HarryBateman/Siren_Electrical/Capture.PNG

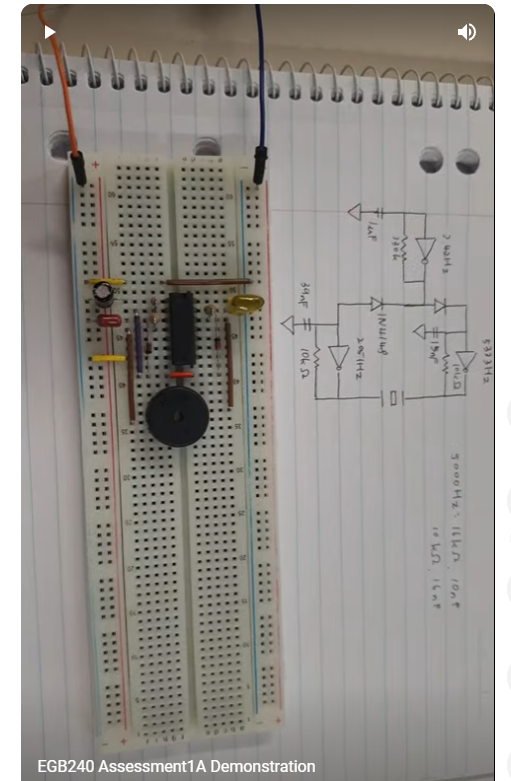
Capture.PNG
