HarryBateman/Siren_Electrical/EGB240_Assessment1_Portfolio_n11291419.pdf

Mark Broadmeadow (n5470897)

# EGB240 Electronic Design

## Assessment 1: PCB Alarm Circuit Design Portfolio

### Submitted 24/03/2023

### Harrison Flatman-Bateman (n11291419)

### Executive Summary

This portfolio documents the design for a Two Tone Siren, which will be fabricated on a printed circuit board (PCB). The design will be constructed with the following specifications:

- Supplied with two AA batteries (3v supply)
- IC socket
- Activated from a slide switch (on-off)
- 2.67Khz and 3.28Khz tones switching at 2Khz (56.46, 41.67 duty cycle respectively)
- supply current 5mA, peak current 19mA.
- Physical size is 55.7 x 27.90 mm (excluding battery holder)

The two-tone siren will be constructed on the top side of the PCB, While the copper wires will be placed on the bottom, to minimise the layers reducing the cost.

### Contents

### 1. Circuit schematic

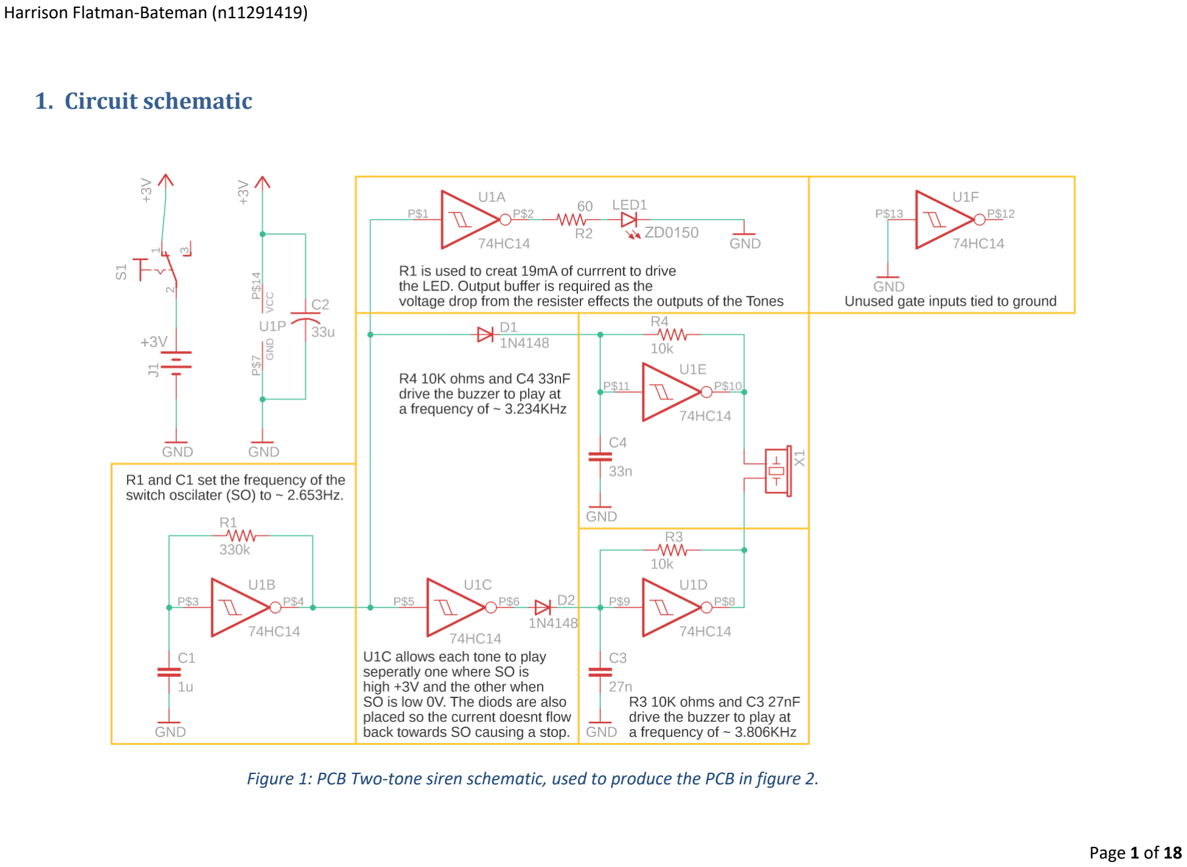
[picture p2: page 2]

Harrison Flatman-Bateman (n11291419)

Page 1 of 18

Figure 1: PCB Two-tone siren schematic, used to produce the PCB in figure 2.

ZD0150

+3V

### 2. Summary of design and operation

Items used in this project was the piezoelectric buzzer (PS1720P02) and The Hex Inverting Schmitt trigger IC (74HC14). The Schmitt trigger is operated by supplying 3V to the supply pin and 0V to the ground trigger which enables the ability to add Schmitt triggers to the circuit, enabling the ability to add oscillators within the circuit to create a two-tone siren circuit.

The piezoelectric buzzer can be used to create a tone supplying a 3V voltage at a specific frequency allowing the ability to create an audible frequency or even a low frequency to drive the switching between the two tones to create a two-tone siren.

The circuit I have created is a two-tone siren circuit with an added LED to emphasize the alarm behaviour. These behaviours were created using the piezoelectric buzzer and The Hex Inverting Schmitt trigger IC. In designing this circuit there is a Switching Oscillator circuit (SO) a low frequency at ~2Hz, to drive the transition between the frequencies (Tone 1, Tone 2). For these Tones to not be played at the same time another Schmitt trigger is placed in between one of the Tones and the Oscillating switch, which causes the two Tones to be out of phase of each other.

A bypass capacitor was added after noticing a distortion when turning on the Two-tone siren, caused by long lengths of wire creating parasitic inductance. this was fixed by implementing a bypass capacitor from the positive and negative pins of the Schmitt trigger IC. However, now when turning off the capacitor a discharge like sound was created by the large capacitance of the 33uF capacitor therefore It has since been changed to 10uF to minimise these effects.

For visual feedback I added a red LED I first added this without another Schmitt trigger however it was causing a voltage drop on the tone generators due to the resistance I needed to power the LED. To fix this issue I put a Schmitt trigger before the resister and the LED to avoid a voltage drop across the tone generators, I used a 60ohm resister at 3 volts to create 19-amp current which was more than enough to power the bulb.

When designing the two-tone siren, the frequencies used to create a tone is important. From diagram 1 I chose to use a frequency that had a high decibel range, considering the fact that the frequencies can be close enough in values to still be distinguished by the user. Tone 1 was chosen to be 3.28KHz and tone 2 2.67KHz. As indicated by the black dots.

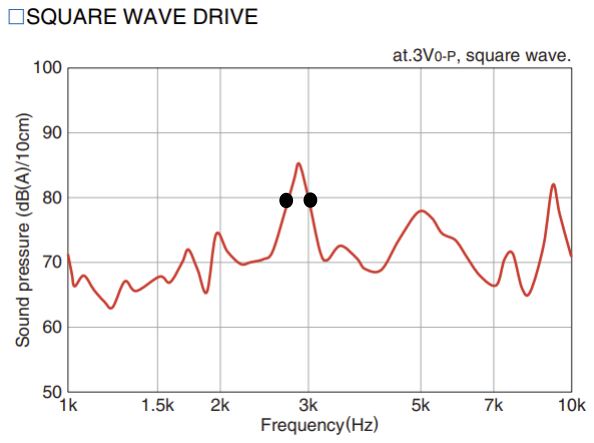
[picture p3: figure]

Diagram 1: decibels produced from different frequency from the buzzer.

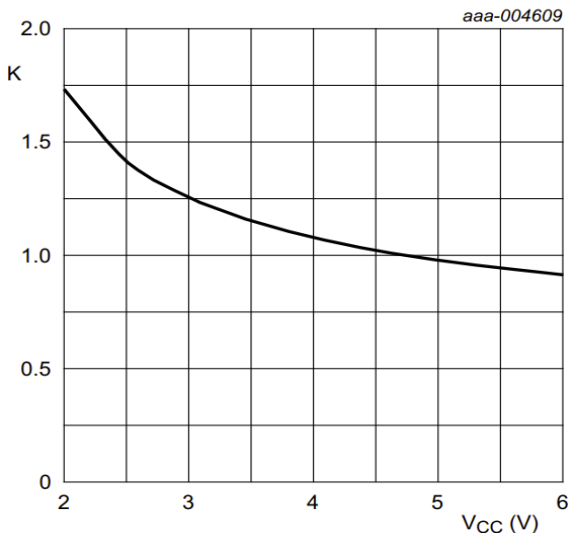
[picture p4: figure]

To calculate the frequencies a K value must be determined from a diagram from the Schmitt trigger diagram. In diagram 2 it shows a value of K respect to the supplied voltage. In this case the system is powered by 2 AA batteries creating 3V therefore the diagram shows the K value being
1.25. To then calculate the frequency the following formular can be used to select an appropriate resister then working backwards to find the desired frequencies.

Using the following formular I can determine a value closes to 3.28KHz and 2.67KHz provided the components within QUT S9 resources:

2.05Hz =

1
1.25 × (390 × 10³) × (1 × 10⁻⁶)

2.424KHz =

1
1.25 × (10 × 10³) × (33 × 10⁻⁹)

2.962KHz =

1
1.25 × (10 × 10³) × (27 × 10⁻⁹)

Using the resister and capacitor values to plug into the schematic will create an output frequency that will be used to create a two-tone siren. For any modifications for the two-tone siren the following diagrams and calculation can be used to create a desired frequency.

Diagram 2: constant value K dictated by the amount of voltage supply used to produce frequency calculations.

Equation 1: used to calculate frequencies from a specific supply voltage, resister, and capacitor.

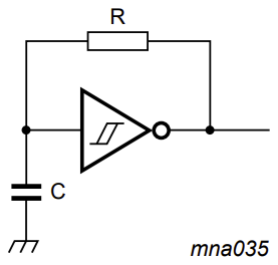
[picture p5: figure]

Diagram 3: Layout used to produce an output frequency.

Page 4 of 18

### 3. PCB layout

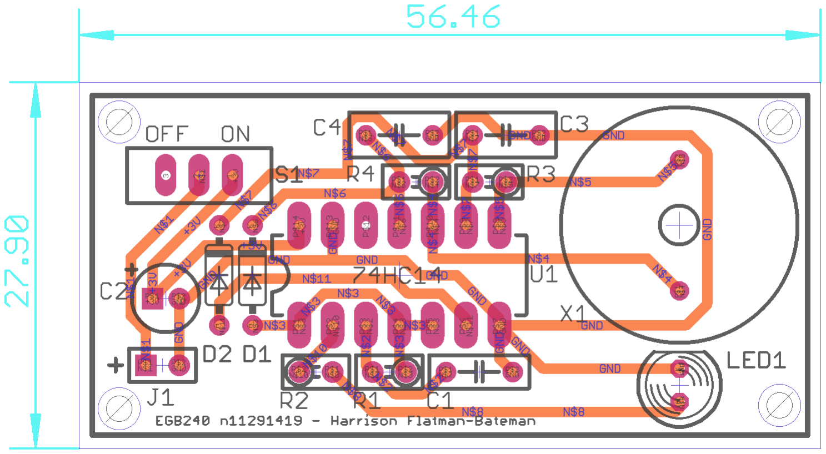
[picture p6: figure]

Figure 2: PCB circuit of the two-tone siren showing the size of the board in mm.

Page 5 of 18

### 4. Bill of materials

Designator Value | Description | Qty | Footprint
C1 | 1u | Capacitor, Radial, Non-polarised, 1uF 35V 12%, 5mm pitch | 1 | CAP-DISC-P5.08
C2 | 33u | Capacitor, Radial, Polarised, 33u 50V, 3.5mm pitch | 1 | CAP-RB-P2.0-D5.0
C3 | 27n | Capacitor, Radial, Non-polarised, MKT, 27nF 100V 10%, 5mm pitch | 1 | CAP-DISC-P5.08
C4 | 33n | Capacitor, Radial, Non-polarised, MKT, 33nF 100V 10%, 5mm pitch | 1 | CAP-DISC-P5.08
D1 | 1N4148 | Diode, 100V 150mA, DO-35 | 1 | DO35-P7.62
D2 | 1N4148 | Diode, 100V 150mA, DO-35 | 1 | DO35-P7.62
LED1 | LED | LED, RED 8mcd Round diffused, 20mA fc, 1.8v fv, 5mm diameter | 1 | ZD0150
J1 | 3V | Battery holder, 3V, 2xAA, flying leads | 1 | BATT-3V
R1 | 330k | Resistor, Axial, Carbon Film, 330K 5% 0.25W | 1 | AXIAL-P2.54
R2 | 60 | Resistor, Axial, Metal Film, 62 1% 0.25W | 1 | AXIAL-P2.54
R3 | 10K | Resistor, Axial, Carbon Film, 10K 1% 0.25W | 1 | AXIAL-P2.54
R4 | 10K | Resistor, Axial, Carbon Film, 10K 1% 0.25W | 1 | AXIAL-P2.54
S1 | | Switch, SPDT, Slide, On-On, 0.1" pitch | 1 | SS-12
U1 | 74HC14 | Hex Schmitt trigger INVERTER, DIP-14 | 1 | DIP-14
U1 | IC socket | IC socket, DIP-14 | 1 | DIP-14
X1 | PS1720P02 | Piezoelectonic buzzer | 1 | PS1720P02

Page 6 of 18

Designator | Manufacturer | MPN | Supplier | SKU | MOQ Price
C1 | Generic | Capacitor, Radial, Non-polarised, 1uF 35V 12%, 5mm pitch | Jaycar | RZ6628 | 1 | 0.75
C2 | Generic | Capacitor, Radial, Polarised, 33u 50V, 3.5mm pitch | Jaycar | RY6818 | 1 | 1.15
C3 | Generic | Capacitor, Radial, Non-polarised, MKT, 27nF 100V 10%, 5mm pitch | Jaycar | RG5090 | 1 | 0.3
C4 | Generic | Capacitor, Radial, Non-polarised, MKT, 33nF 100V 10%, 5mm pitch | Jaycar | RM7095 | 1 | 0.35
D1 | NXP | 1N4148 | Jaycar | ZR-1100 | 1 | 0.95
D2 | NXP | 1N4148 | Jaycar | ZR-1100 | 1 | 0.95
LED1 | Generic | LED, RED 8mcd Round diffused, 20mA fc, 1.8v fv, 5mm diameter | Jaycar | ZD0150 | 1 | 0.4
J1 | Generic | Battery holder, 3V, 2xAA, flying leads | Jaycar | PH-9202 | 1 | 1.6
R1 | Generic | Resistor, Axial, Carbon Film, 330K 5% 0.25W | Jaycar | RR2834 | 1 | 0.68
R2 | Generic | Resistor, Axial, Metal Film, 62 1% 0.25W | Jaycar | RR0543 | 1 | 0.85
R3 | Generic | Resistor, Axial, Carbon Film, 10K 1% 0.25W | Jaycar | RR2798 | 1 | 0.68
R4 | Generic | Resistor, Axial, Carbon Film, 10K 1% 0.25W | Jaycar | RR2798 | 1 | 0.68
S1 | NKK Switches | SS12SDP4 | Digi Key | 360-2922-ND | 1 | 4.94
U1 | Texas Instruments | SN74HC14N | Jaycar | ZC-4821 | 1 | 2.75
U1 | Texas Instruments | IC socket, DIP-14 | Jaycar | PI-6501 | 1 | 0.5
X1 | TDK | PS1720P02 | Element14 | 1669968 | 1 | 1.35

Page 7 of 18

### 5. Assembly overlay

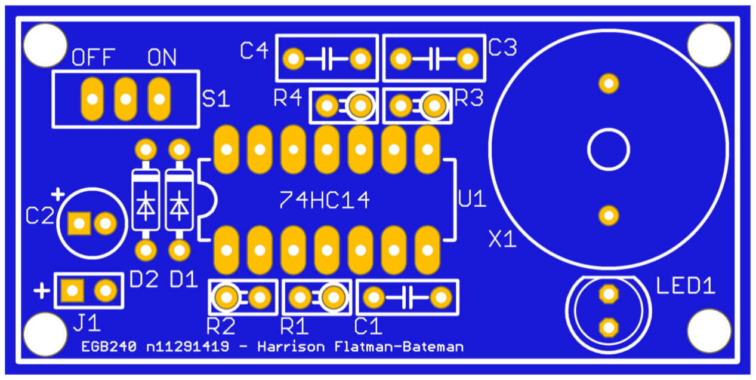
[picture p7: figure]

Figure 3: Assembly overlay and instructions for two-tone siren.

When constructing the board, it is important that the respected diode and other polarised components face their respected positions. This can be dictated by the thick line for a diode and a positive icon for a polarised capacitor. It is also important to Solder in the IC socket before implementing the Schmitt trigger IC, this allows the IC to be easily replaced or removed when required.

M3 bolt size holes have been produced for an industry standard mounting option. with a 3.2mm diameter hole to account for any clearance issues.

### 6. Photos of assembled prototype

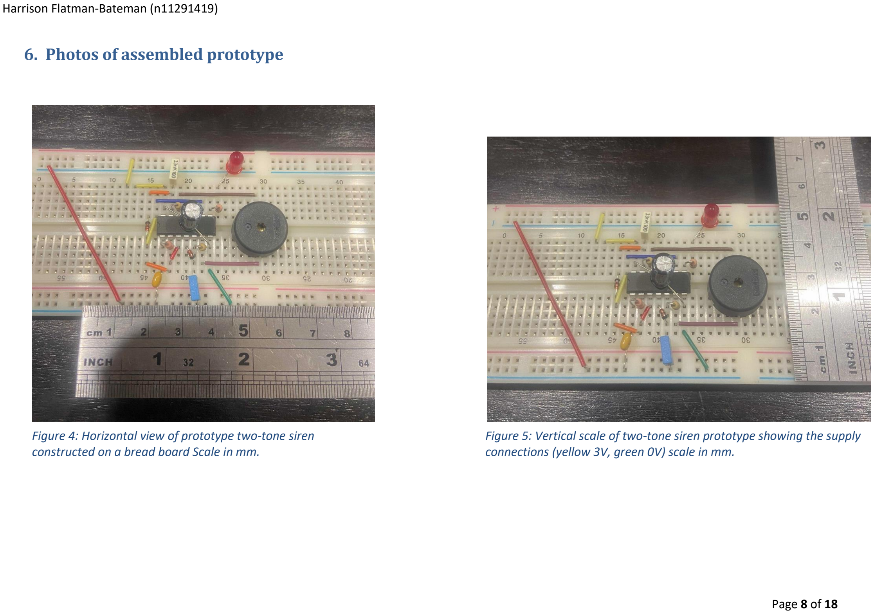
[picture p8: page 9]

Page 8 of 18

Figure 4: Horizontal view of prototype two-tone siren constructed on a bread board Scale in mm.

Figure 5: Vertical scale of two-tone siren prototype showing the supply connections (yellow 3V, green 0V) scale in mm.

### 7. Simulation circuit and results

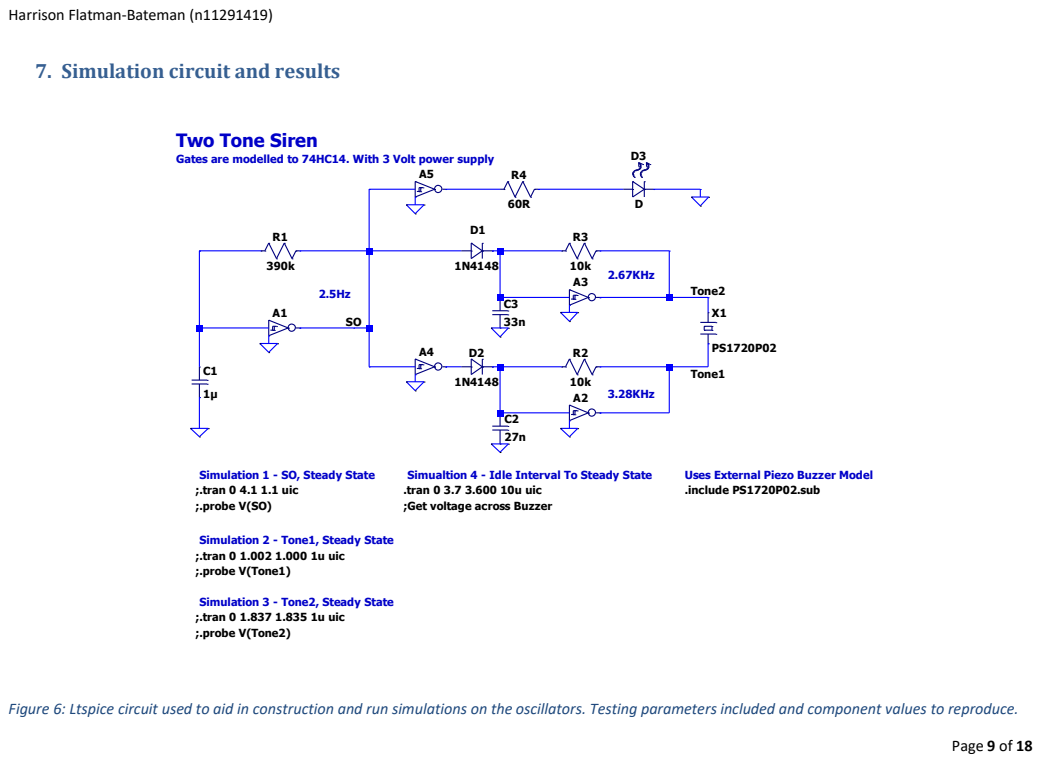
[picture p9: page 10]

Gates are modelled to 74HC14. With 3 Volt power supply

Simulation 1 - SO, Steady State
;.tran 0 4.1 1.1 uic
;.probe V(SO)

Simualtion 4 - Idle Interval To Steady State
.tran 0 3.7 3.600 10u uic
;Get voltage across Buzzer

Uses External Piezo Buzzer Model
.include PS1720P02.sub

Figure 6: Ltspice circuit used to aid in construction and run simulations on the oscillators. Testing parameters included and component values to reproduce.

Page 10 of 18

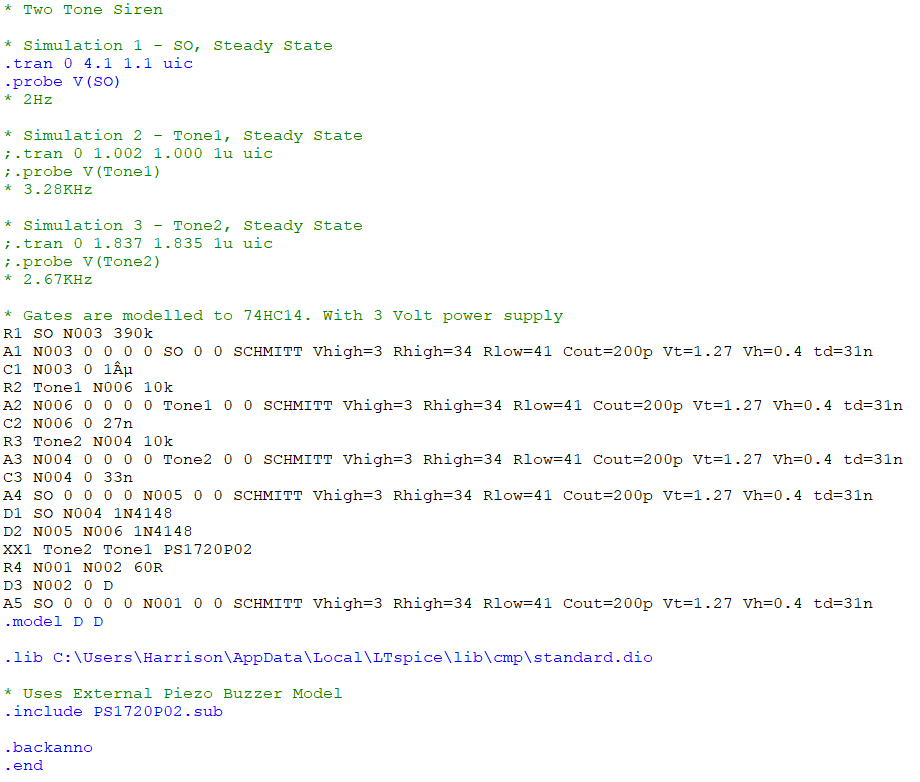
[picture p10: figure]

Figure 7: Ltspice netlist for circuit in figure 6.

Page 11 of 18

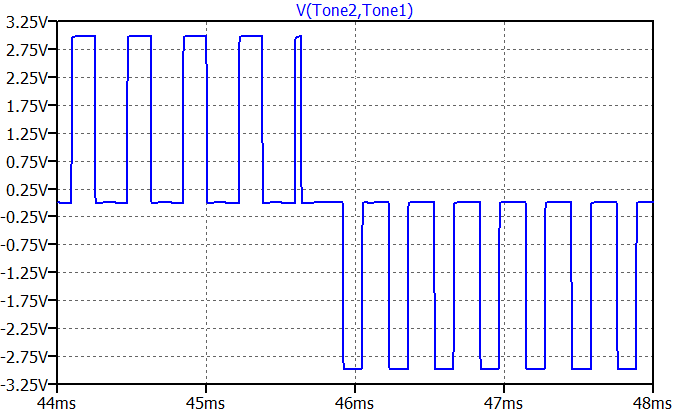
[picture p11: figure]

Figure 8: Plot of the voltage across the buzzer showing the correlation between the oscillating switch and the two tones.

Figure 8 shows the switch changing, causing the tone from the buzzer changing from 2.67KHz to 3.28KHz causing Tone 1 from figure 6 to flow in the opposite direction showing the buzzers peak at -3V after 46ms.

Page 12 of 18

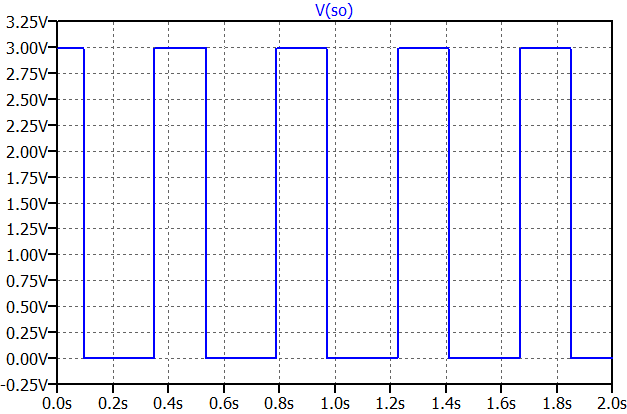
[picture p12: figure]

Figure 9: Plot of the oscillating switch that controls when the tones switch driving the two tones to play separately.

Page 13 of 18

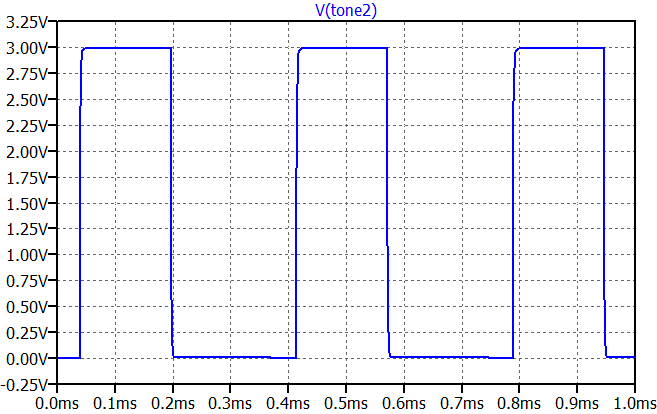
[picture p13: figure]

Figure 20: Shows tone 2 with a frequency of 2.67KHz and a duty cycle of 46.67%

Page 14 of 18

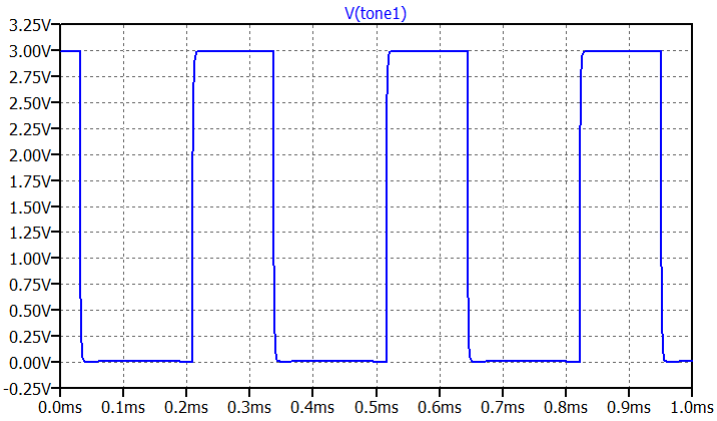
[picture p14: figure]

Figure 11: Shows tone 1 with a frequency of 3.28KHz and a duty cycle of 41.67%

Page 15 of 18

### 8. Experimental results

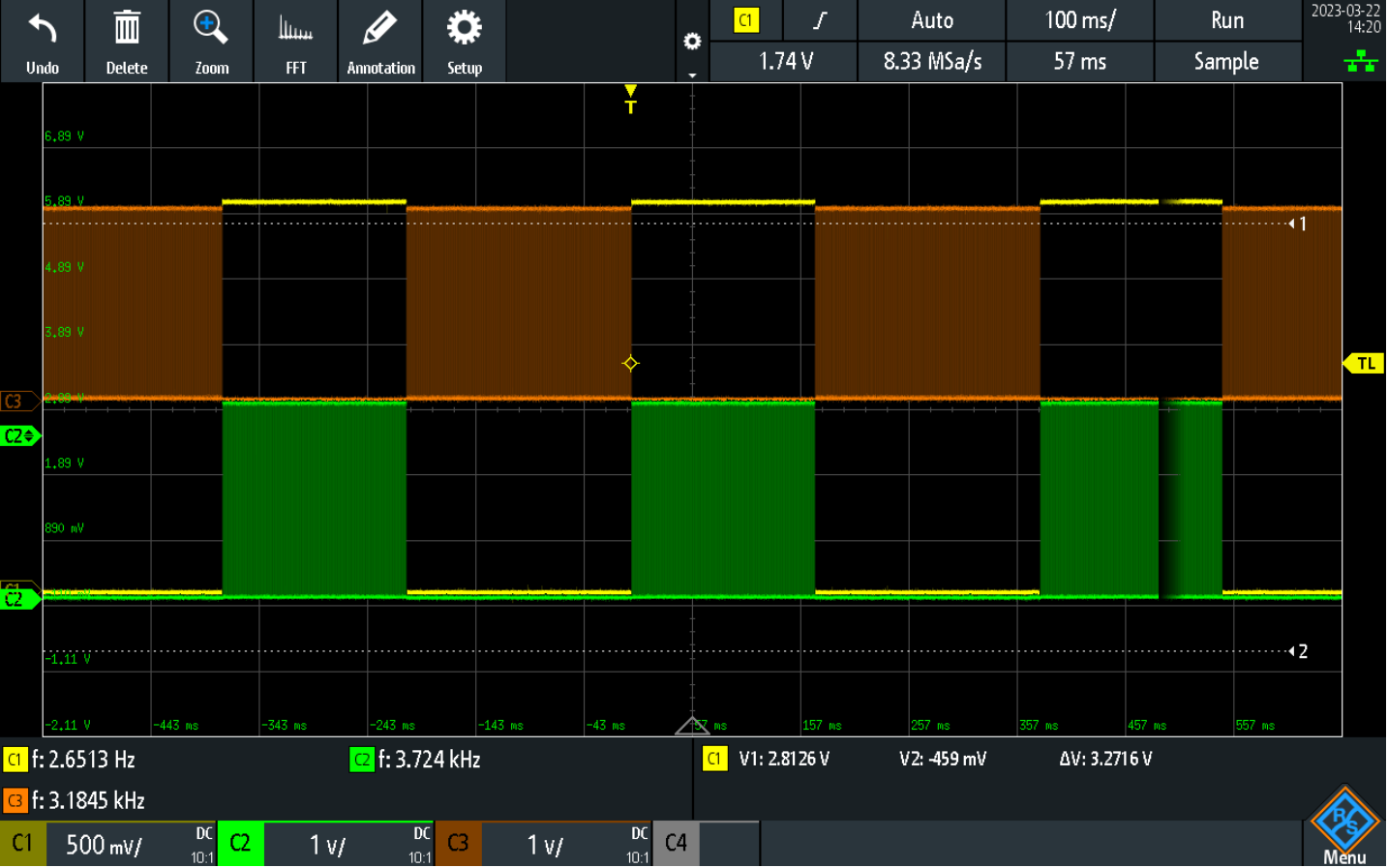
[picture p15: figure]

Figure 13:The oscilloscope captures the relations between the switching oscillator and two tones generated by the IC.

As the switching oscillator is driven low (0V) Tone 2 from figure 6 is switched on and generates a frequency of 3.184Khz for the buzzer. When the switch is driven high to 3V, Tone 2 is then turned off and Tone 1 starts playing with a frequency of 3.724KHz.

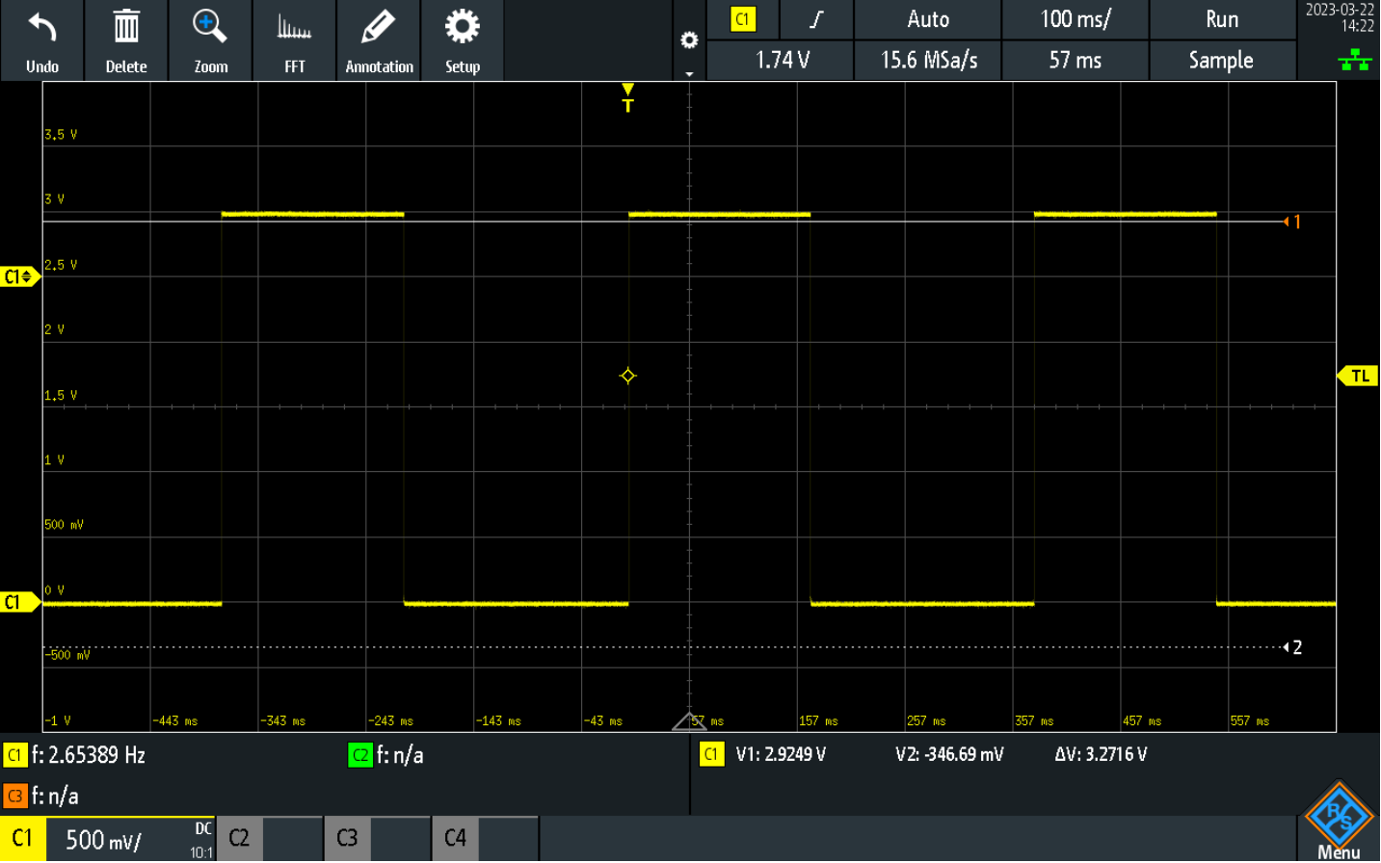
[picture p16: figure]

Page 16 of 18

Figure 14: Captured on the oscilloscope shows the oscillating switch, at a frequency of 2.653Hz and a duty cycle of 44.82%

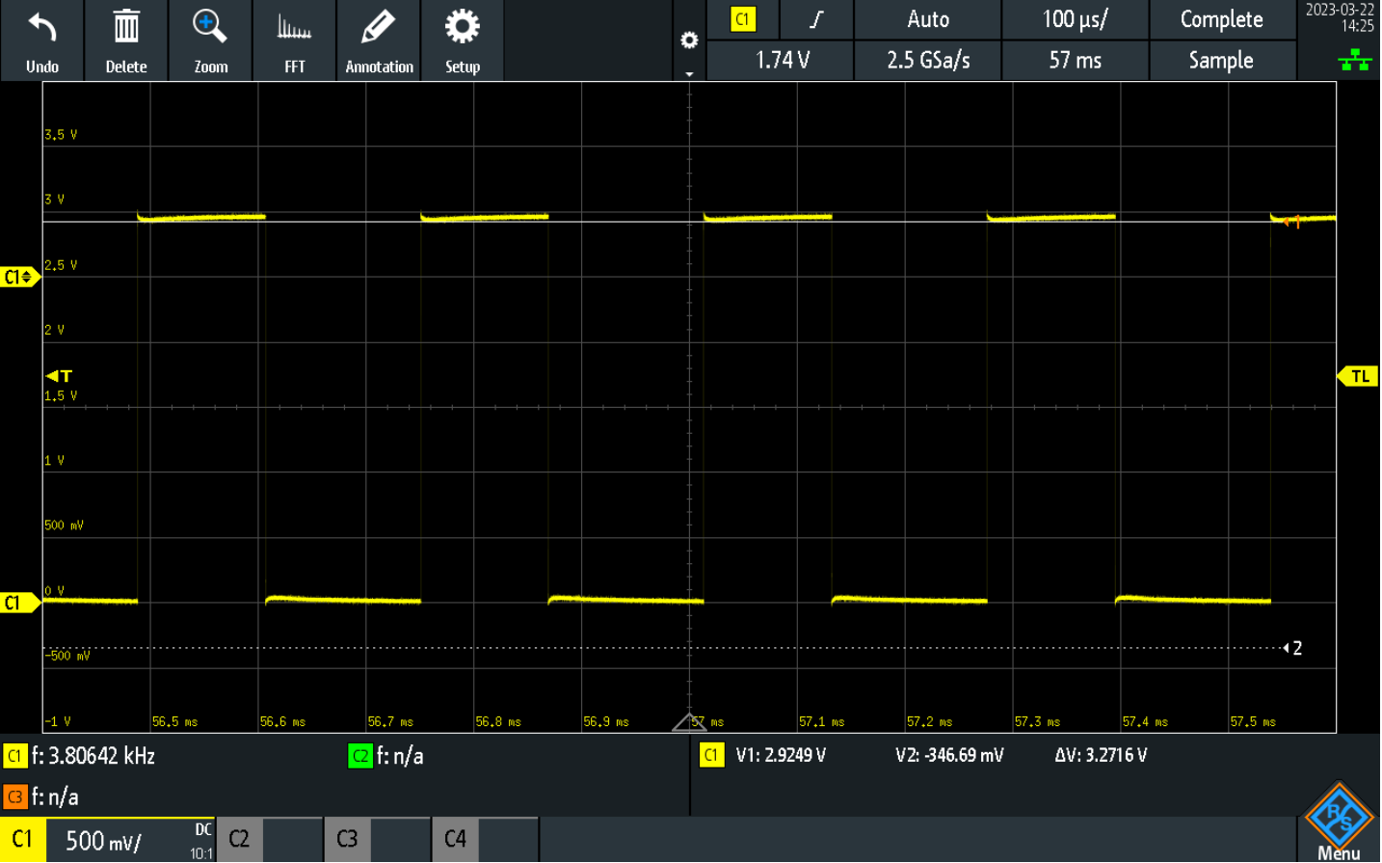
[picture p17: figure]

Page 17 of 18

Figure 15: captures tone 1 from figure 6 with a frequency of 3.806KHz and a duty cycle of 41.67%

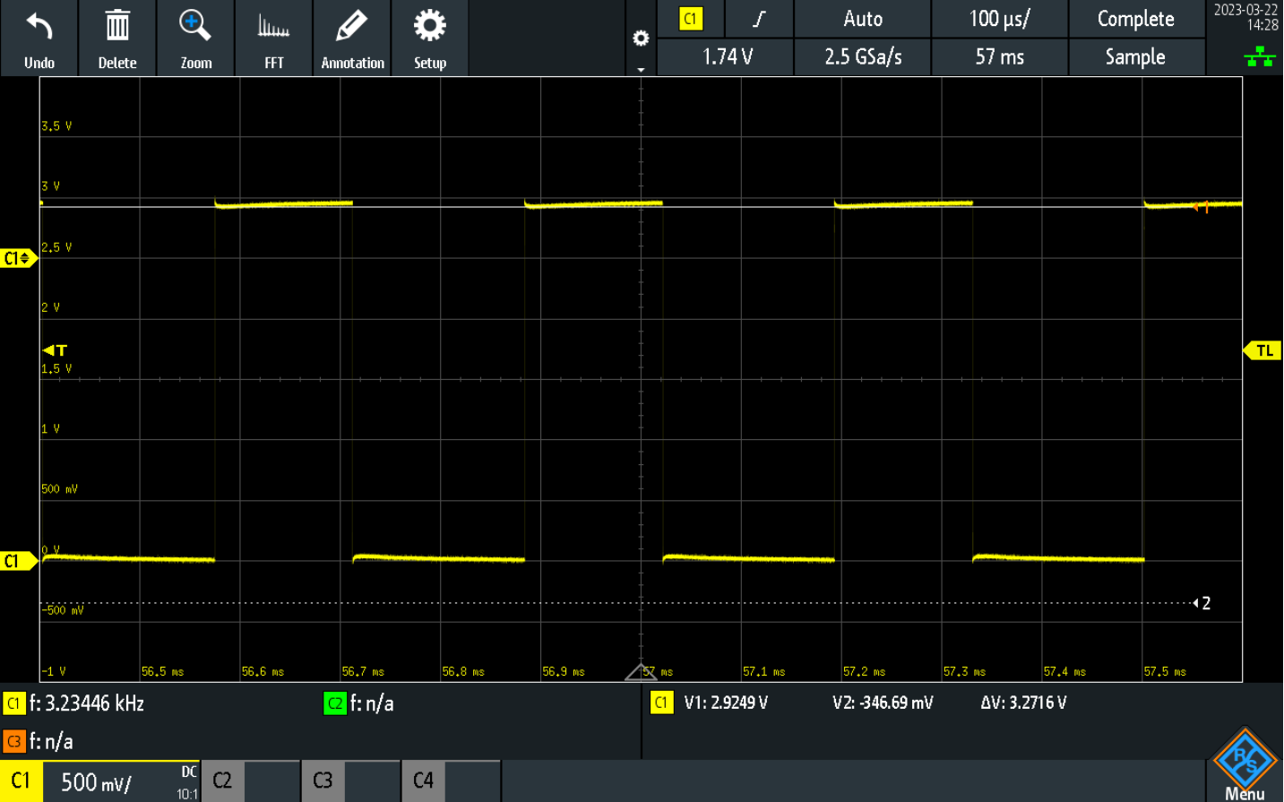
[picture p18: figure]

Page 18 of 18

Figure 16:Ccaptures tone 2 from figure 6 with a frequency of 3.234KHz and a duty cycle of 46.67%
