HarryBateman/Siren_Electrical/Data/soin.PNG

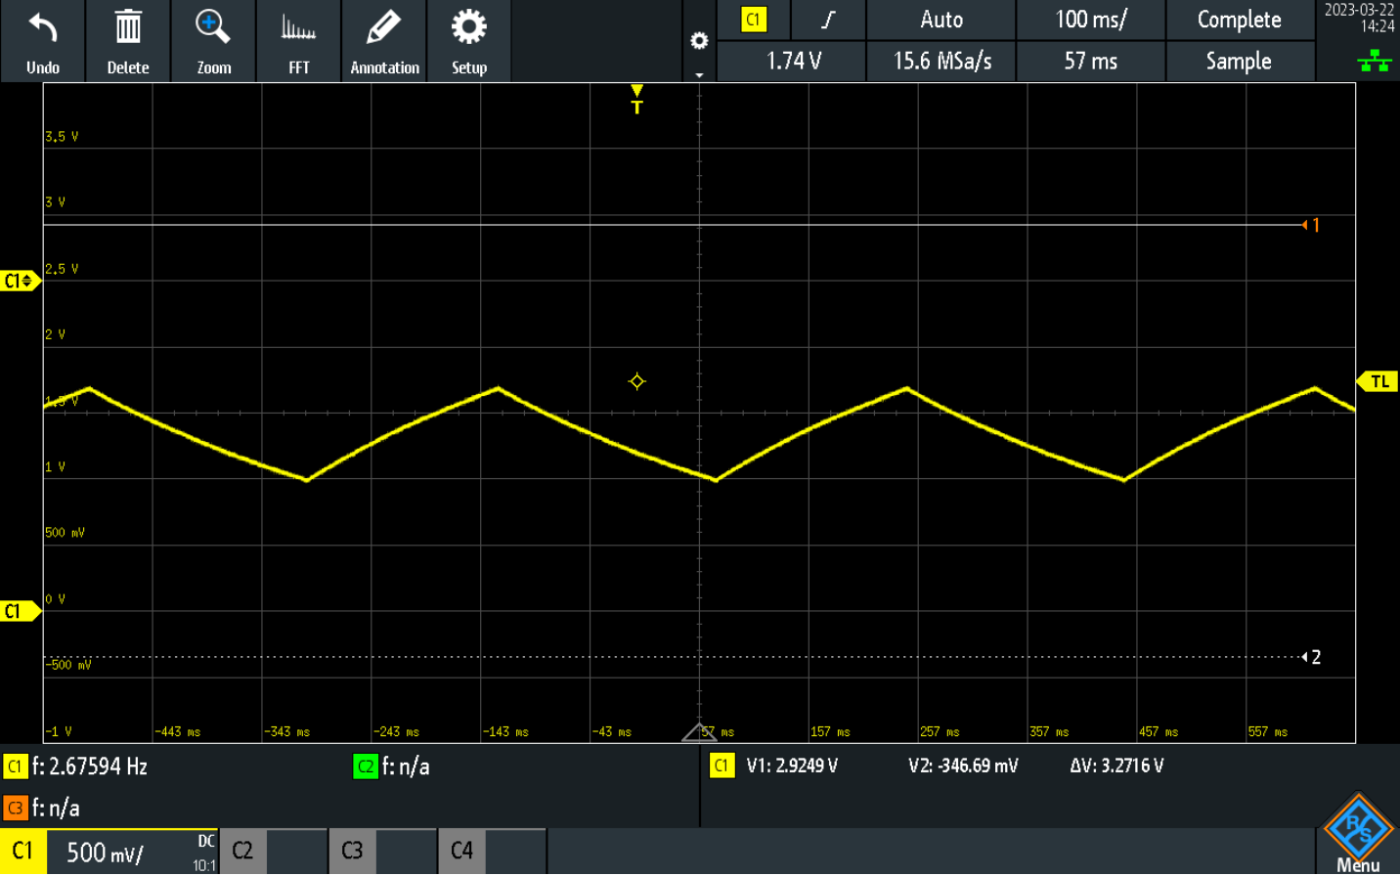
Data/soin.PNG
