HarryBateman/Siren_Electrical/Data/tin.PNG

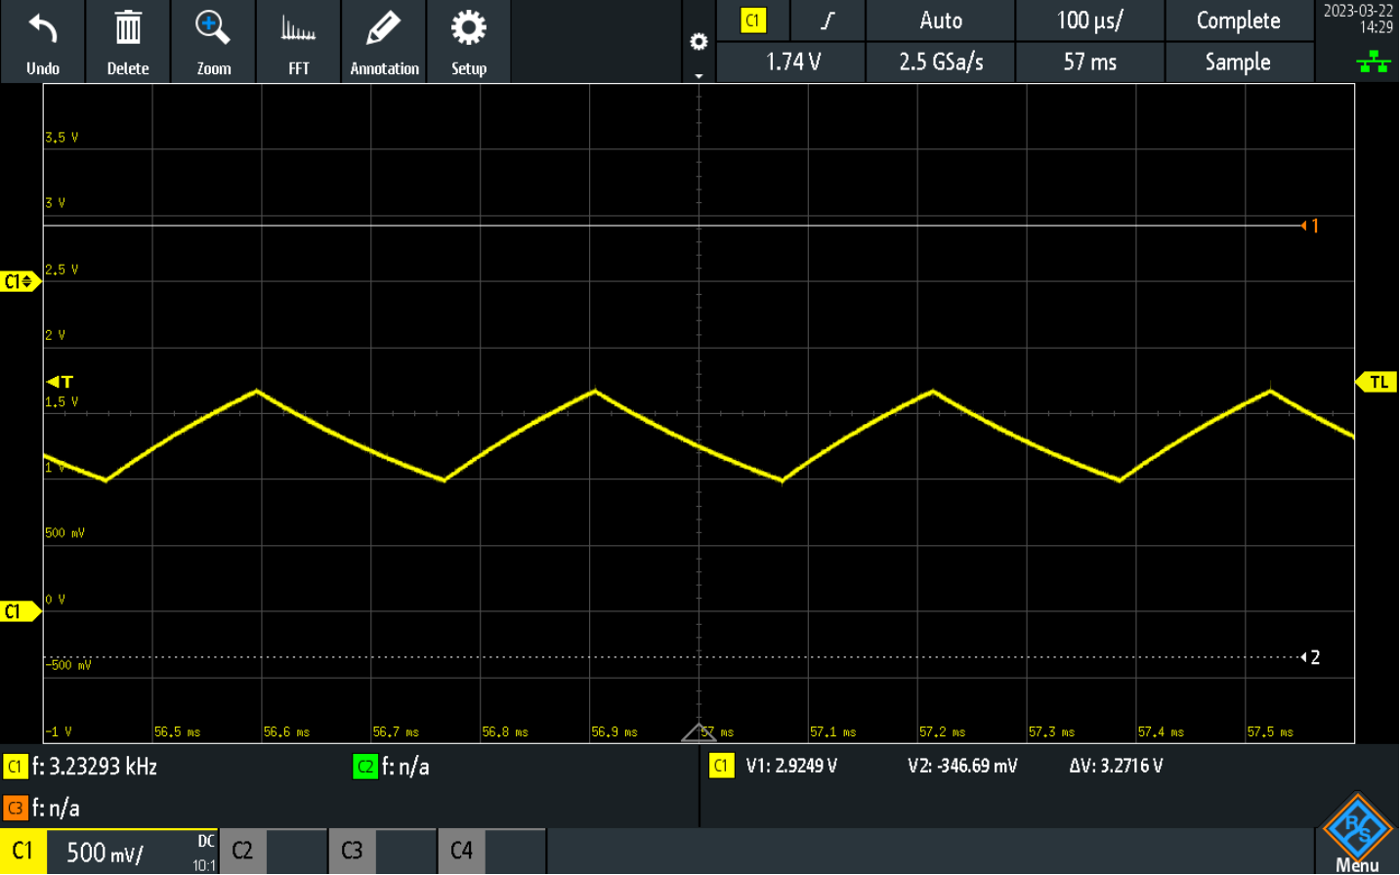
Data/tin.PNG
