HarryBateman/Siren_Electrical/Eagle/1.PNG

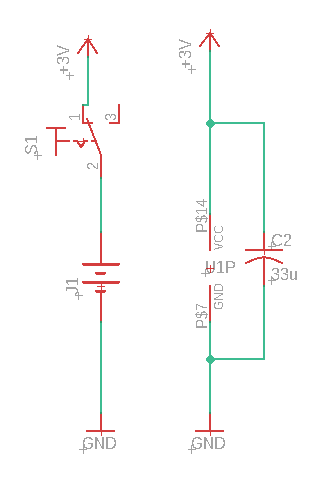
Eagle/1.PNG
