HarryBateman/Siren_Electrical/Eagle/2.PNG

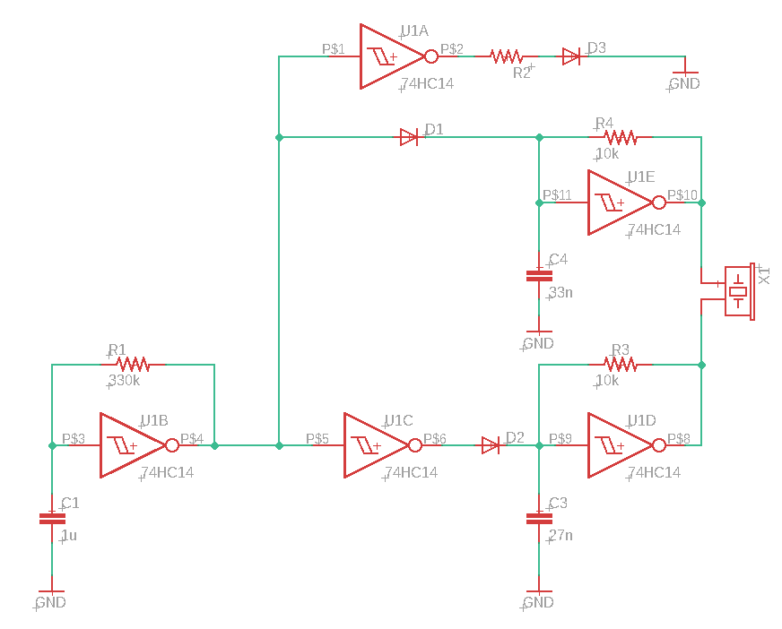
Eagle/2.PNG
