HarryBateman/Siren_Electrical/Eagle/EGB240_n11291419.png

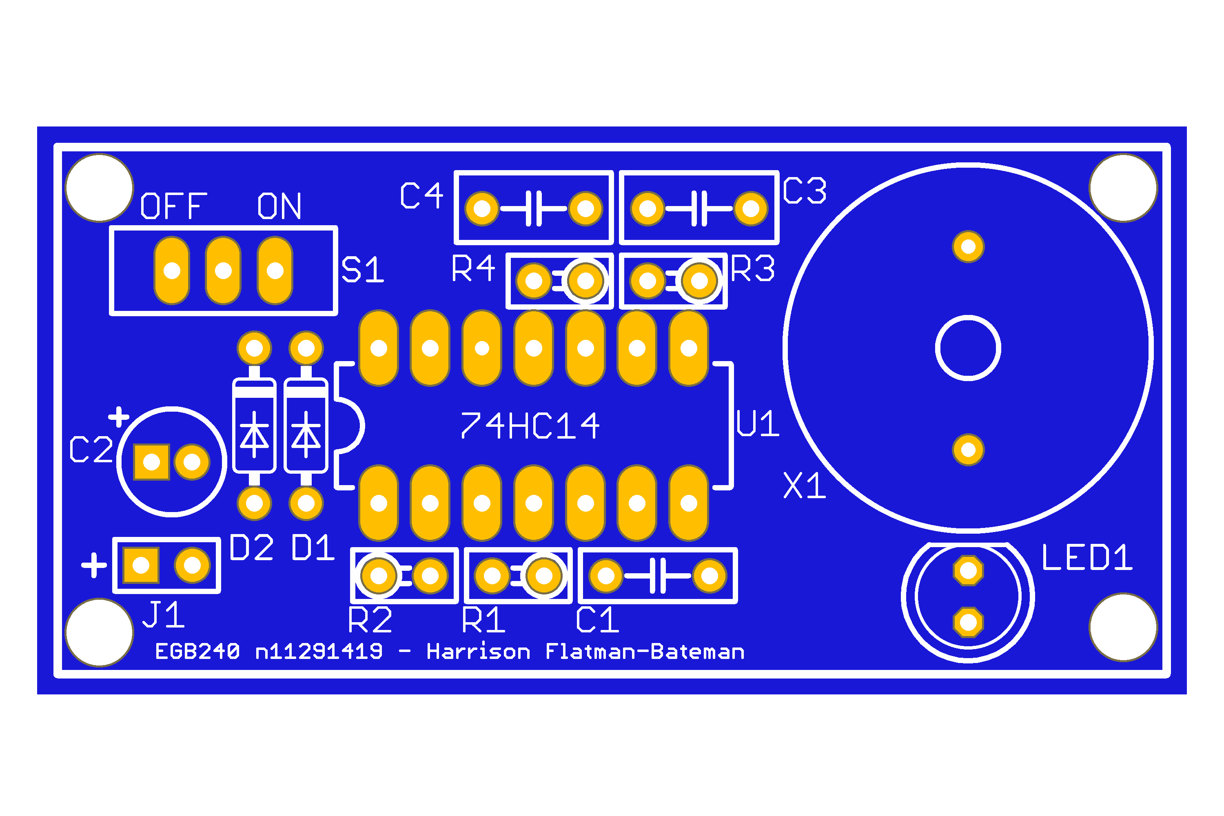
Eagle/EGB240_n11291419.png
