HarryBateman/Siren_Electrical/Eagle/imgg.png

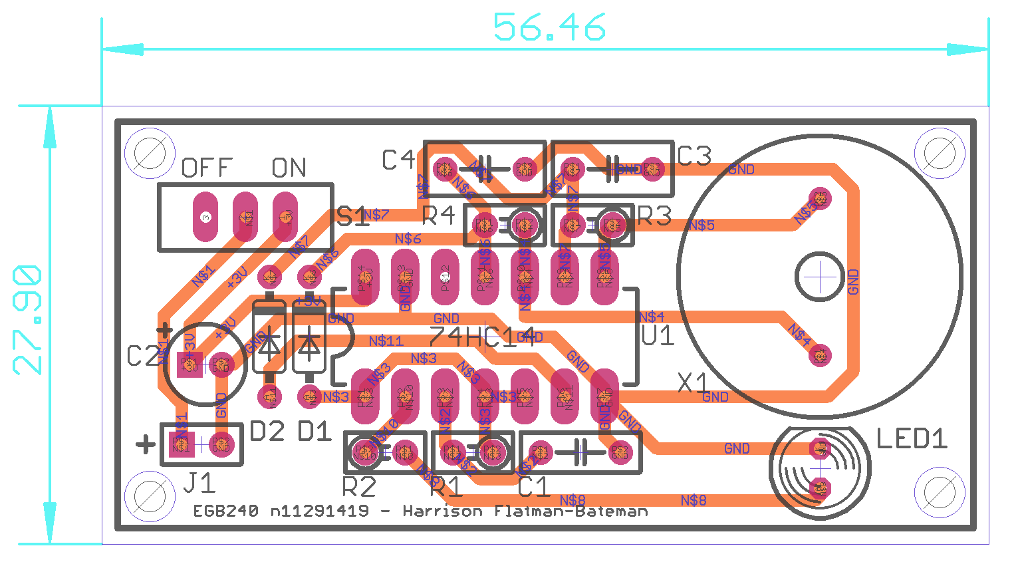
Eagle/imgg.png
