HarryBateman/Siren_Electrical/LTspice/W2.asc

A1: schmtinv; Vhigh=3 Rhigh=34 Rlow=41 Cout=200p Vt=1.27 Vh=0.4 td=31n
C1: Cap; 1µ
R1: Res; 1k
Named nets: 0
.tran 0 5m 0 0.1u
