HarryBateman/Siren_Electrical/LTspice/WorkShop2.asc

A1: schmtinv; Vhigh=3 Rhigh=34 Rlow=41 Cout=200p Vt=1.27 Vh=0.4 td=31n
A2: schmtinv; Vhigh=3 Rhigh=34 Rlow=41 Cout=200p Vt=1.27 Vh=0.4 td=31n
A3: schmtinv; Vhigh=3 Rhigh=34 Rlow=41 Cout=200p Vt=1.27 Vh=0.4 td=31n
A4: schmtinv; Vhigh=3 Rhigh=34 Rlow=41 Cout=200p Vt=1.27 Vh=0.4 td=31n
C1: Cap; 1µ
C2: Cap; 25n
C3: Cap; 29n
D1: diode
D2: diode
R1: Res; 800k
R2: Res; 10k
R3: Res; 10k
Named nets: 0
.tran 0 20m 0 0.1u
3.1-2.7
1.11Hz
3.52Hz
2.97Hz
