HarryBateman/Siren_Electrical/Eagle/Draft/EGB240_n11291419.brd

## EAGLE design Eagle/Draft/EGB240_n11291419.brd (2024-12-18)

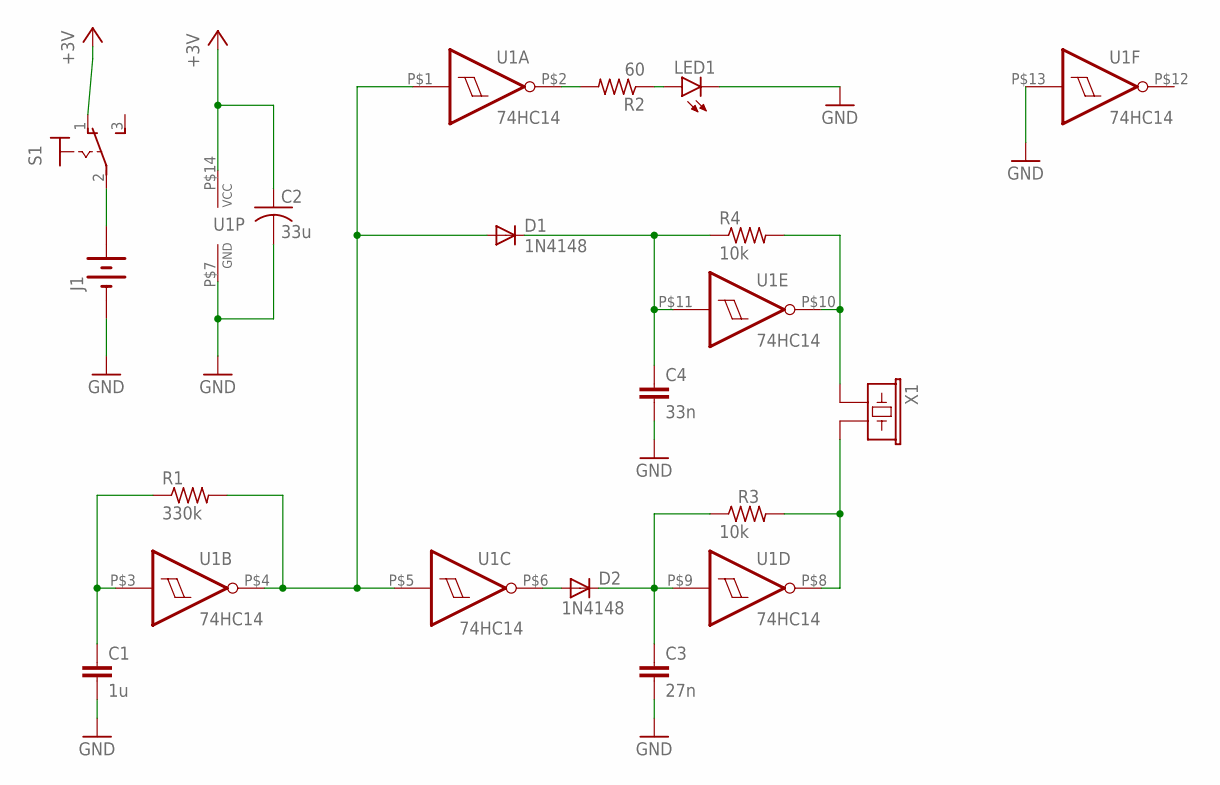
[picture p25: schematic EGB240_n11291419.sch]

Parts:
C1: 1u; CAP-DISC-P5.08
C2: 33u; CAP-RB-P2.0-D5.0
C3: 27n; CAP-MKT-7.5X3.2-P5.08
C4: 33n; CAP-MKT-7.5X3.2-P5.08
D1, D2: 1N4148; DO35-P7.62
J1: BATTERY-3VBATT; BATT-3V
LED1: LED5MM
R1: 330k; AXIAL-P2.54
R2: 60; AXIAL-P2.54
R3, R4: 10k; AXIAL-P2.54
S1: SWITCH-SPDT; SS-12
U1: 74HC14; DIP-14
X1: BUZZER-PIEZOPS1720P02; PS1720P02

Connections:
+3V: C2.P$1 (1), S1.1 (O), U1.P$14 (VCC)
GND: C1.P$2 (2), C2.P$2 (2), C3.P$2 (2), C4.P$2 (2), J1.P$2 (-), LED1.K (C), U1.P$7 (GND), U1.P$13 (I)
unnamed: J1.P$1 (+), S1.2
unnamed: C1.P$1 (1), R1.P$1 (1), U1.P$3 (I)
unnamed: D1.A, R1.P$2 (2), U1.P$1 (I), U1.P$4 (O), U1.P$5 (I)
unnamed: R4.P$2 (2), U1.P$10 (O), X1.P$1 (1)
unnamed: R3.P$2 (2), U1.P$8 (O), X1.P$2 (2)
unnamed: C4.P$1 (1), D1.K, R4.P$1 (1), U1.P$11 (I)
unnamed: C3.P$1 (1), D2.K, R3.P$1 (1), U1.P$9 (I)
unnamed: LED1.A, R2.P$1 (1)
unnamed: R2.P$2 (2), U1.P$2 (O)
unnamed: D2.A, U1.P$6 (O)

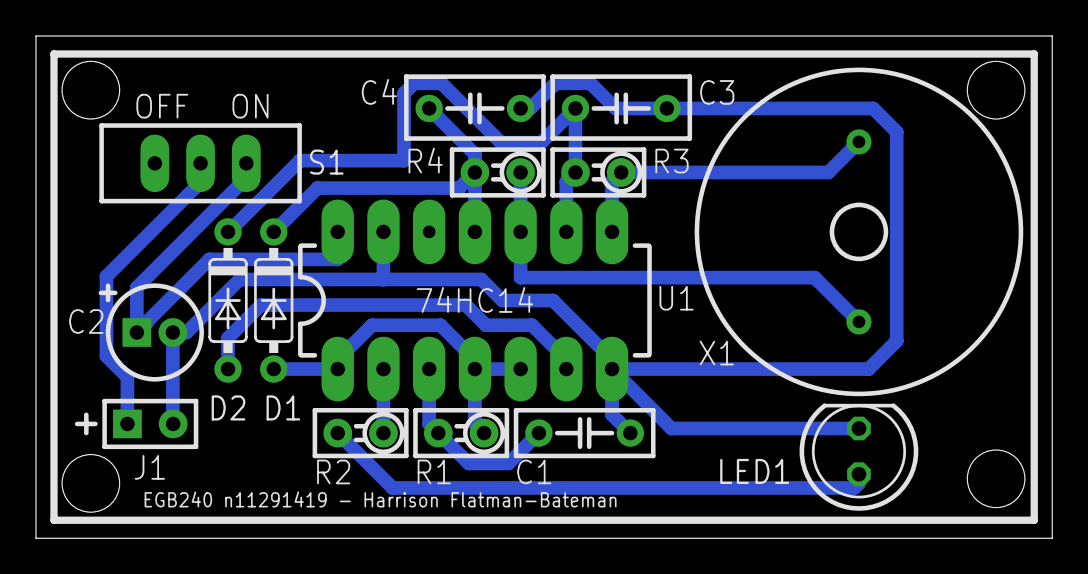
[picture p26: board EGB240_n11291419.brd from above]

Board: 2 copper layers, 56.5 x 27.9 mm, 15 parts (0 on the bottom side), 12 nets.
